unichronic/auvsim/README.md

# Adaptive Sonar Transmitter Payload — SIH26058

A low-power, real-time adaptive software-defined sonar transmitter for autonomous underwater
vehicles (AUVs) — built for Smart India Hackathon problem statement **SIH26058** (Ministry of
Earth Sciences / National Institute of Ocean Technology).

## The problem

AUV side-scan sonar performance is set by the physical characteristics of the transmitted
"ping." A high-frequency chirp (~500 kHz) gives sharp images but scatters instantly in muddy
or deep water; a low-frequency chirp (~100 kHz) penetrates murky water and travels far but
yields a blurry image. Sound also behaves differently with depth, turbidity, temperature and
salinity. For an AUV to map effectively without draining its battery, the transmitter needs to
behave like a software-defined radio — reshaping its analog pulse waveform in real time based
on what the water is actually doing.

## What's in this repository

- **[`sonar-transmitter/`](sonar-transmitter/)** — the physical hardware payload: pin-labelled
  pictorial wiring diagrams for all 9 build stages, full component specs and pin map, the
  golden-reference modulation/windowing simulator with its result set, and completed firmware.
  Start here for the hardware side.
- **Everything else at this repo's root** — the pre-silicon simulation bench: eight
  independent verification stages (integer-exact firmware reference, R-2R Monte Carlo, an
  independent SPICE cross-check, FPGA RTL simulation, an absorption/propagation model, and
  full scenario coverage against the problem statement), an interactive signal-lab GUI, and a
  hosted API. Laptop-verifies the whole transmitter chain before hardware measurement.
  Documented in full below.

## Architecture

```
Sensors → Adaptation logic (RP2040) → sample buffer (SRAM) → PIO + DMA
   → 74HC574 latch → 8-bit R-2R ladder DAC → 3rd-order active filter
   → analog amplitude control (digital pot, ahead of the output stage)
   → op-amp output → BNC → oscilloscope / spectrum analyser
```

Samples stream through the RP2040's PIO and DMA hardware at roughly **10 megasamples per
second with zero CPU cycles spent per sample** — the CPU is free to run the adaptation loop
and telemetry concurrently. The DAC is a hand-built 8-bit R-2R resistor ladder, not a DAC chip:
at 10 MS/s it reaches the real transmit band the problem statement describes, and it upgrades
cleanly on the same parallel-bus interface if a faster DAC is swapped in later. Amplitude is
controlled **in the analog domain** (a digital potentiometer ahead of the output op-amp), not
by scaling digital sample values — digital scaling costs DAC resolution exactly when the
signal is smallest. Four real sensors (temperature, turbidity, salinity, battery/power state)
plus one potentiometer standing in for depth (a bench cannot reproduce real hydrostatic
pressure, and the problem statement explicitly permits a dial for that one variable) drive an
adaptation loop that picks centre frequency, bandwidth, pulse duration, amplitude, and one of
three modulation types (LFM chirp, geometric sweep, Barker-13 phase code) every pulse.

Full component specs, pin map and rationale: [`sonar-transmitter/COMPONENTS.md`](sonar-transmitter/COMPONENTS.md).
Full stage-by-stage wiring diagrams: [`sonar-transmitter/diagrams/`](sonar-transmitter/diagrams/).

## Chosen algorithm and results

The modulation engine (LFM chirp, geometric sweep, Barker-13 phase code, all four required
windows) is verified by two independent simulation paths before any hardware measurement:
an integer-exact golden reference matched against a byte-for-byte RTL simulation of the actual
FPGA DDS, and a from-scratch Monte Carlo / SPICE cross-check of the analog chain. Highlights:

| Finding | Result |
|---|---|
| Quantisation SQNR, windowed LFM chirp (Hann / Blackman) | 45.7 / 44.9 dB |
| Reconstruction filter image rejection at the first DAC image (9.5 MHz) | 93.0 dB combined (analytic), 69.0 dB confirmed through the full time-domain chain |
| **Barker-13 phase code must use a rectangular window** | Confirmed independently in both simulators: tapering collapses the matched-filter sidelobe from ≈−22 dB to as little as −3.8 to −4.8 dB — windowing helps the chirps and destroys the phase code |
| **1% resistors are not good enough for the R-2R ladder** | 13.4% of Monte Carlo draws are non-monotonic, SFDR degrades to −49 dBc against a −48 dBc target. 0.1% gives 0% non-monotonic and 1.8 dB margin |
| Quarter-wave sine LUT sizing on the target FPGA | Exactly 100% of the SLG47910's block RAM (32,768 of 32,768 bits) — not "ample" as first assumed; quarter-wave symmetry is required, not optional |
| Digitally-scaled amplitude at 25%, SQNR cost | 37.7 dB (≈6 bits) — confirms analog amplitude control is the right call |
| Cross-check: nodal R-2R solve vs. an independent SPICE simulator | Agree to 6.9×10⁻¹⁴ LSB across all 256 codes |
| Cross-check: Verilog DDS vs. the Python golden reference | Byte-for-byte match over all 8,192 samples |

Full methodology and the complete numbers: [`sonar-transmitter/sim/README.md`](sonar-transmitter/sim/README.md)
(the hardware-facing simulator) and the [stage map](#stage-map) and
[cross-validation](#cross-validation) sections below (the full pre-silicon bench).

## Status

**Gates:** 7 of 8 pre-silicon verification gates pass (see [Status](#status) below) — the
remaining gate needs a synthesis run through the FPGA vendor's own GUI toolchain, which can't
be scripted.

**Hardware build:** the signal-chain architecture, component selection and modulation
algorithm are finalised and simulation-verified. Hardware bring-up follows a nine-stage,
test-gated build so a fault is caught at the smallest possible stage rather than debugged
blind in a fully assembled system:

- **Stage 1** — toolchain and first blink: passed
- **Stage 2** — DAC bus wiring proof (all 8 bus lines verified, correct identity, no bridges): passed
- Stages 3–9 (sensors, the R-2R ladder build, first waveform, filter/amplifier, full
  modulation set, closing the adaptation loop, power optimisation) — in progress

This covers the waveform engine, validated electrically per this round's requirements — no
transducer, water, or acoustic transmission is required or claimed this round. The acoustic
chain attaches at the BNC output, a deliberate module boundary, without requiring any change
upstream of it.

## What we looked at before deciding this

We researched a broad range of publicly documented approaches to this class of problem before
settling on this architecture. The patterns found, summarised without naming specific
projects: [`sonar-transmitter/research/DESIGN_RESEARCH.md`](sonar-transmitter/research/DESIGN_RESEARCH.md).

## License

MIT — see [`LICENSE`](LICENSE).

---

# Pre-silicon simulation bench

Laptop verification of the whole transmitter chain before any part is ordered.

**Not the deliverable.** SIH26058 requires a physical hardware unit — the build lives in
[`sonar-transmitter/`](sonar-transmitter/). This bench is preparation, and the
predicted-vs-measured overlay is evidence the system is understood, never a substitute for
building it.

## Run it

```bash
python3 run_all.py      # every runnable stage, then the gate check
```

or individually:

```bash
python3 run_sim0.py     # golden reference + C tables      (no extra tools)
python3 sim1_diff.py    # bit-exact firmware diff          (gcc)
python3 run_sim2.py     # R-2R Monte Carlo + filter        (no extra tools, ~90 s)
python3 run_sim4.py     # predicted spectrogram            (no extra tools)
python3 run_sim5.py     # absorption + adaptation table    (no extra tools)
python3 sim6_scenarios.py # PS scenarios → sensor inputs → adaptive sonar
python3 gate_check.py   # the 8 go/no-go gates
python3 sim2_spice_check.py  # ngspice vs the nodal solve, 256 codes
python3 sim3_check.py        # gateware diff vs SIM-0
```

The reusable ForgeFPGA baseline project is [`ForgeFpgaDDS.ffpga`](ForgeFpgaDDS.ffpga),
with the Shrike wrapper and pin map documented in
[`sim3_gateware/FORGEFPGA.md`](sim3_gateware/FORGEFPGA.md). It is the vendor-tool
input for the first Gate 6 synthesis pass; it does not replace the required
ForgeFPGA resource report or prove that the LUT array mapped to dedicated BRAM.

## Use the interactive signal lab

The original bench validates one fixed transmitter chain. The local GUI adds
the experiment loop: up to four configurable sensor channels with distinct
default behaviors (tone, up-chirp, burst, and dropout), recorded CSV/TXT trace
import, explicit water/environment controls, a selectable frequency algorithm,
all three PS waveform families (LFM, geometric, and phase-coded BPSK), an
explicit software-plugin handoff, and a separate hardware circuit model.
The patch bay keeps the simulated netlist visible:

```text
sensor inputs → algorithm → 32-bit DDS → 8-bit R-2R → reconstruction filter → output probe
```

The board is draggable; sensor blocks can be moved with a mouse or keyboard.
The hardware plane exposes clock, phase-accumulator, DAC, reference, filter,
and resistor-tolerance specs. The software plane lets you open the source file
you want to check, edit it in the browser, select a test scenario, and report
whether the adapter contract passed alongside the output frequency, voltage,
FTW, coherence, and waveforms.

The environment plane exposes temperature, salinity, depth, pH, source range,
ambient noise, and turbidity. For modeled channels, those values affect sound
speed, frequency-dependent Ainslie-McColl absorption, a clearly-labelled
turbidity scattering heuristic, propagation phase delay, and the noise floor
before estimation. Uploaded traces are not re-shaped: they are treated as
measurements that already include the conditions of their capture. These are
propagation-level preview controls, not calibrated transfer functions for the
project's final sensor hardware.

PS 26058 does not specify a number, model, or datasheet for the environmental
sensors. The four default inputs are therefore deliberately generic acoustic
fixtures. They exercise fusion, dropout, burst, chirp, and trace-import paths;
they are not claimed to be the project's physical sensors. To make the bench
project-accurate, map each selected sensor's model number/datasheet to its
response, sensitivity, bandwidth, and calibration file.

```bash
python3 launch_gui.py
# open http://127.0.0.1:8765
```

The GUI is dependency-free. `launch_gui.py` serves it locally; the same static
frontend and simulation are Vercel-ready through `vercel.json` and `api/`.
The sensor models are deterministic and reproducible; a recorded trace is
resampled at the configured simulation clock. The software editor is a safe
contract check: it does not execute arbitrary pasted code. A plugin must
contain the configured entrypoint (normally `on_measurement`) and call
`bench_set_algorithm(...)` or `bench_set_algorithm_from_config(...)`. The
selected algorithm then drives the hardware model. This is the integration
seam for the real product plugin; provide its SDK/API when it is ready to
replace the contract check with an actual compiler/runtime adapter.

## Run the PS scenarios

`sim6_scenarios.py` is the scenario-level experiment for SIH26058. It runs the
two conditions named by the PS—**Entering Muddy Estuary** and **Entering Clear
Shallow Reef**—plus the interpretable deployment classes: brackish transition,
deep clear, deep muddy, high-noise harbor, cold freshwater, warm hypersaline,
both hysteresis-boundary sides, and legal minimum/maximum input limits. Each
class runs through three coherent modeled acoustic input channels, the
existing fusion/DDS path, and an adaptive water-channel preview. The three
channels are a test harness for redundant input fusion, not a claim that the PS
requires three physical sensors.

The Shrike-Lite policy is intentionally small and deterministic: condition the
environment readings, select a fixed-point lookup profile with hysteresis on the
RP2040, and leave deterministic DDS/window/pulse synthesis to the FPGA. The
current profiles are LFM + Hann: 100–200 kHz for muddy water and 300–500 kHz
for clear shallow water. The coverage matrix also exercises all 12 environment
classes × 3 waveform families × 4 requested windows, sensor behaviors,
algorithm choices, hardware limits, invalid inputs, and frame-by-frame
clear→boundary→muddy→boundary→fault→dropout→recovery transitions. The exact integer DAC
path is used for LFM, geometric, and BPSK pulse checks. Phase-coded pulses use
a rectangular envelope even when another window is requested, because tapering
would change the Barker-chip correlation. The script writes
`out/sim6_scenario_report.json` plus `out/sim6_scenario_comparison.png`.
In the GUI, the scenario selector exposes the full catalog and the waveform
controls select the active modulation/window. Loading any catalog entry routes
the selected adaptive pulse through the modeled DDS → R-2R → filter → probe
chain. The **Run realtime coverage** action sends the complete environment
catalog through all waveform/window combinations in a bounded frame API, then
injects malformed configuration, sensor dropout, and recovery. Custom water
conditions can use either continuous DDS exploration or adaptive pulse output.

The sonar result is a relative link-budget preview, not a physical detection
claim. It currently omits target strength, beam pattern, multipath, transducer
efficiency, amplifier limits, and calibrated sediment particle data. Those must
be measured in a tank or open-water test before hardware settings are frozen.

## Deploy for team use

Vercel is the supported hosted path. Import this repository into Vercel or run
`vercel` from the repository root. The platform serves the `gui/` assets and
maps `/api/simulate` and `/api/status` to the Python Functions in `api/`.
The hosted API path uses no third-party runtime dependencies;
`launch_gui.py` remains the local path.

Hosted runs are independent per browser: the current layout is stored in
`localStorage`, not in a shared database. The hosted API uses the Python
standard library only and receives the submitted
sensor, hardware, connection, and plugin-contract payload for each run. Add
authentication and persistent storage before putting sensitive code or shared
project state behind a public URL. Netlify can serve the static GUI, but the
current Python API needs a separate service or a JavaScript/TypeScript port.

`POST /api/realtime` accepts a bounded `{base, frames, frame_period_ms}` payload.
Each frame may update the environment, waveform mode, and sensor state; malformed
frame data is reported as a recoverable fault; the
response reports selected profiles, hysteresis transitions, recoverable faults,
and host-side deadline measurements. It is a stateless deployment preview, not
a WebSocket or a substitute for measuring the RP2040 timer/DMA loop on the
target board.

It does not replace ForgeFPGA synthesis, the existing RTL/SPICE stages, or a
physical sensor/analog test. Those remain separate verification steps, while
the GUI gives you a repeatable whole-system test bench before those tools run.

## Design parameters

Everything lives in `params.py`. 8-bit R-2R ladder at 10 MS/s, 100–500 kHz
acoustic band, first image at 9.5 MHz, 3rd-order reconstruction filter at
700 kHz, Renesas SLG47910 (1120 LUTs, 32 kb BRAM, 50 MHz osc + PLL).

## Stage map

| stage | what it does | tools |
|---|---|---|
| `sim0_reference.py` | integer-exact golden reference (phase accumulator, LUT, Q15 window) | numpy/scipy |
| `sim1_firmware/` + `sim1_diff.py` | the real RP2040 routine compiled for x86, diffed byte-for-byte | gcc |
| `sim2_r2r.py` | R-2R Monte Carlo by exact nodal analysis | numpy |
| `sim2_filter.py` | reconstruction filter, slew and GBW headroom | scipy |
| `sim2_spice/` + `sim2_spice_check.py` | SPICE netlists — independent cross-check | ngspice ✅ |
| `sim3_gateware/` + `sim3_check.py` | DDS RTL with quarter-wave LUT | iverilog ✅ |
| `run_sim4.py` | chained prediction: codes → ladder → ZOH → filter → FFT | numpy/scipy |
| `sim5_propagation.py` | Ainslie-McColl + François-Garrison absorption | numpy |
| `sim6_scenarios.py` | PS scenarios → filtered inputs → Shrike-Lite pulse/link preview | numpy/scipy/matplotlib |

## Things this exercise actually found

1. **A 4096×8 sine LUT is exactly 100% of the SLG47910's BRAM** (32768 of
   32768 bits), not "ample". Quarter-wave symmetry (1025×8 = 25%) is required,
   not an optimisation.

2. **Quarter-wave symmetry needs an explicit +1 correction on the negative
   half.** The table is `round(127.5 + 127.5·sin)`, and `floor(-x) ≠ -floor(x)`,
   so naive negation is one LSB high across all 2047 negative-half entries —
   even-order distortion. Encoded in `dds.v`, verified over all 4096 addresses.

3. **Never window a phase-coded pulse.** Barker-13's −22.3 dB autocorrelation
   depends on equal-amplitude chips; tapering destroys it (−21.8 dB rect →
   −3.8 dB Blackman). Windowing helps the chirps and ruins the code.

4. **1% resistors are genuinely not good enough**: 13.4% of Monte Carlo draws
   are non-monotonic and SFDR degrades 10.7 dB worst case, landing at −49 dBc
   against a −48 dBc target. 0.1% gives 0% non-monotonic and 1.8 dB.

5. **Filter section order matters, and an op-amp macromodel can lie.** The
   first netlist draft put the passive RC pole *before* the Sallen-Key, which
   loads it: the corner fell to 449 kHz and 500 kHz droop was 3.6 dB instead
   of 0.5 dB. Moving the RC after the op-amp output fixed it. Separately, the
   placeholder op-amp had `Cp=39.8p`, giving GBW = 2e12 Hz — an ideal part
   that would have hidden every bandwidth problem the stage exists to find.
   Correct value for 20 MHz GBW with A0=1e5 and Rp=200 is `Cp=3.98u`.

6. **Down-chirps are where fixed-point bugs hide.** C's `/` truncates toward
   zero, Python's `//` floors; they agree only while the numerator is
   non-negative. An up-chirp passes either way, a down-chirp does not —
   `sim1_diff.py` carries a `lfm_down` case specifically to catch it.

## Toolchain

`iverilog` 13.0 and `ngspice` 47 are built from source into `~/.local`
(already on PATH via `.bashrc`). The disk was full, so they were **built in
`/dev/shm`** — a 7.7 GB tmpfs — and only the ~50 MB of final binaries landed
on disk. `gperf` was built first; iverilog's git tarball needs it to generate
its keyword lexer. No conda env and no user data deleted.

To rebuild: `gperf` → `iverilog` (run `sh autoconf.sh` first) → `ngspice`
(`./autogen.sh`, `--without-x --enable-xspice`), each `--prefix=$HOME/.local`.

## Cross-validation

Numbers confirmed by independent routes, which is the point of the structure:

- filter image rejection: −68.0 dB analytic vs 69.0 dB measured through the
  full SIM-4 time-domain chain
- 350 kHz SFDR: −60.2 dBc (SIM-0) vs −59.8 dBc (SIM-2 ideal ladder)
- absorption: Ainslie-McColl vs François-Garrison agree within 7% over 1–900 kHz
- ideal R-2R nodal solve reproduces V(255) = VREF·255/256 to 1e-14 LSB
- **ngspice agrees with the Python nodal solve to 6.9e-14 LSB across all 256
  codes** — the Monte Carlo behind the 0.1% resistor decision is confirmed by
  an independent circuit simulator
- **the Verilog DDS matches SIM-0 byte-for-byte over 8192 samples** in real
  RTL simulation, confirming the quarter-wave LUT and its +1 correction
- retuned filter netlist: −0.40 dB at 500 kHz and −69.3 dB at 9.5 MHz in
  ngspice, against −0.54 dB and −68.0 dB analytic

## Status

7 of 8 gates pass; all six stages run. Gate 6 remains partial for one reason
only: the BRAM question is answered and the RTL now passes real iverilog
simulation against SIM-0, but **LUT count needs a ForgeFPGA Workshop synthesis
run** — a proprietary GUI tool that cannot be scripted. Everything else,
including both independent cross-checks, is green.
