unichronic/auvsim/sonar-transmitter/diagrams/stage1_blink.png

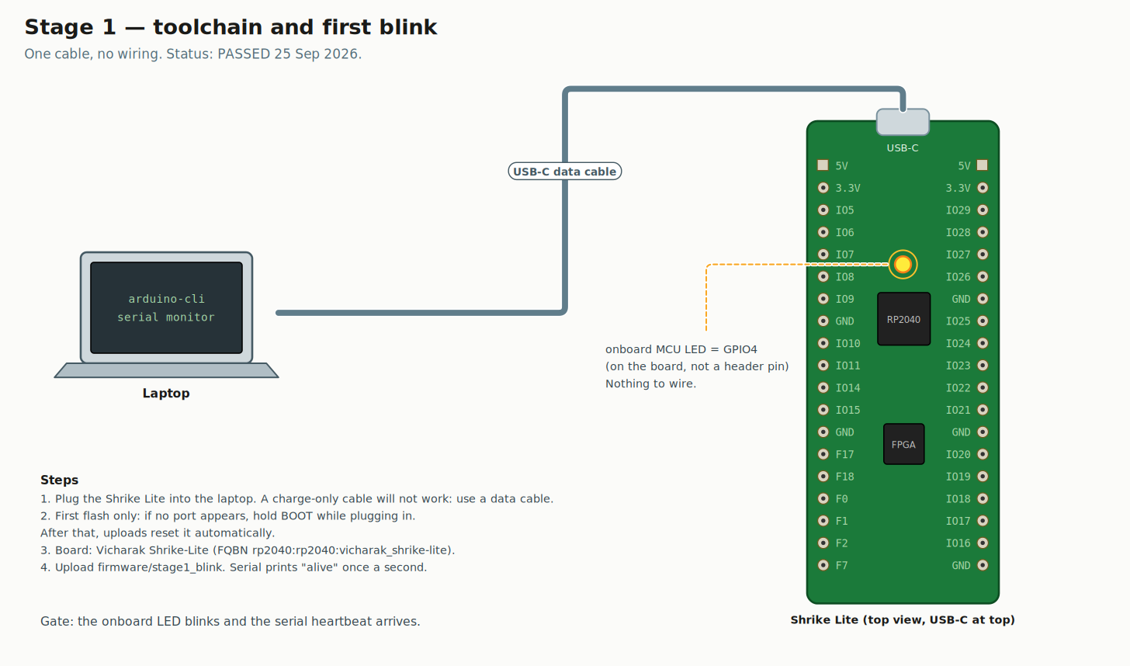
sonar-transmitter/diagrams/stage1_blink.png
