unichronic/auvsim/sonar-transmitter/diagrams/stage2_bus_loopback.png

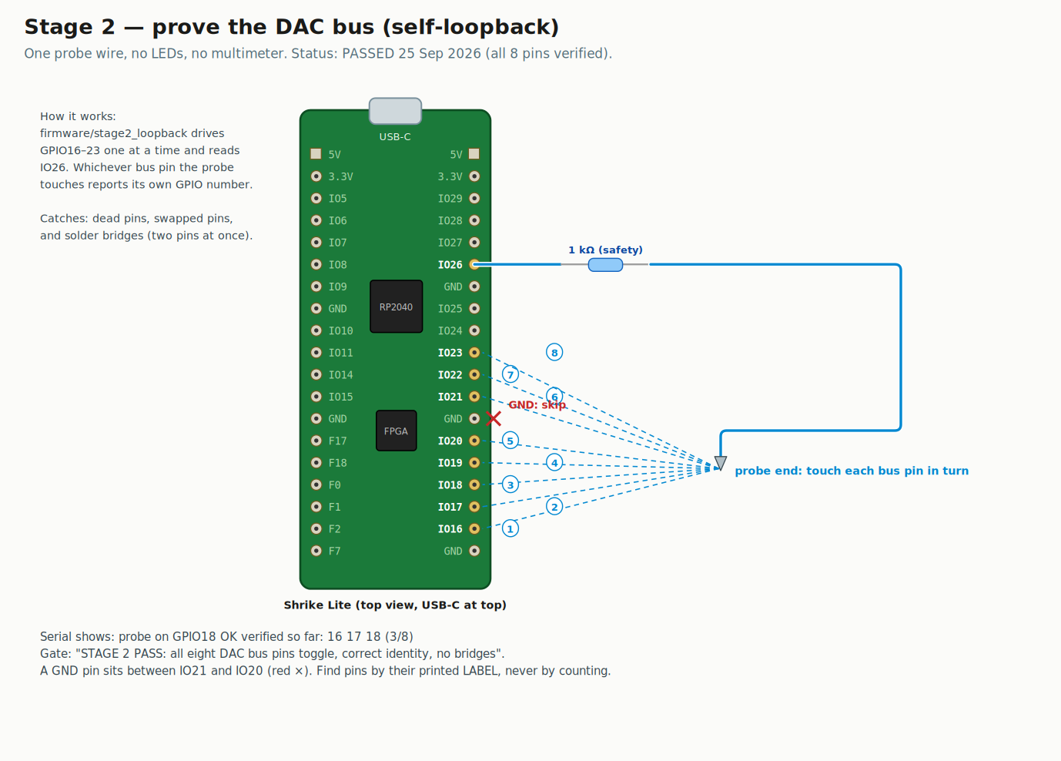
sonar-transmitter/diagrams/stage2_bus_loopback.png
