unichronic/auvsim/sonar-transmitter/diagrams/stage3_sensors.png

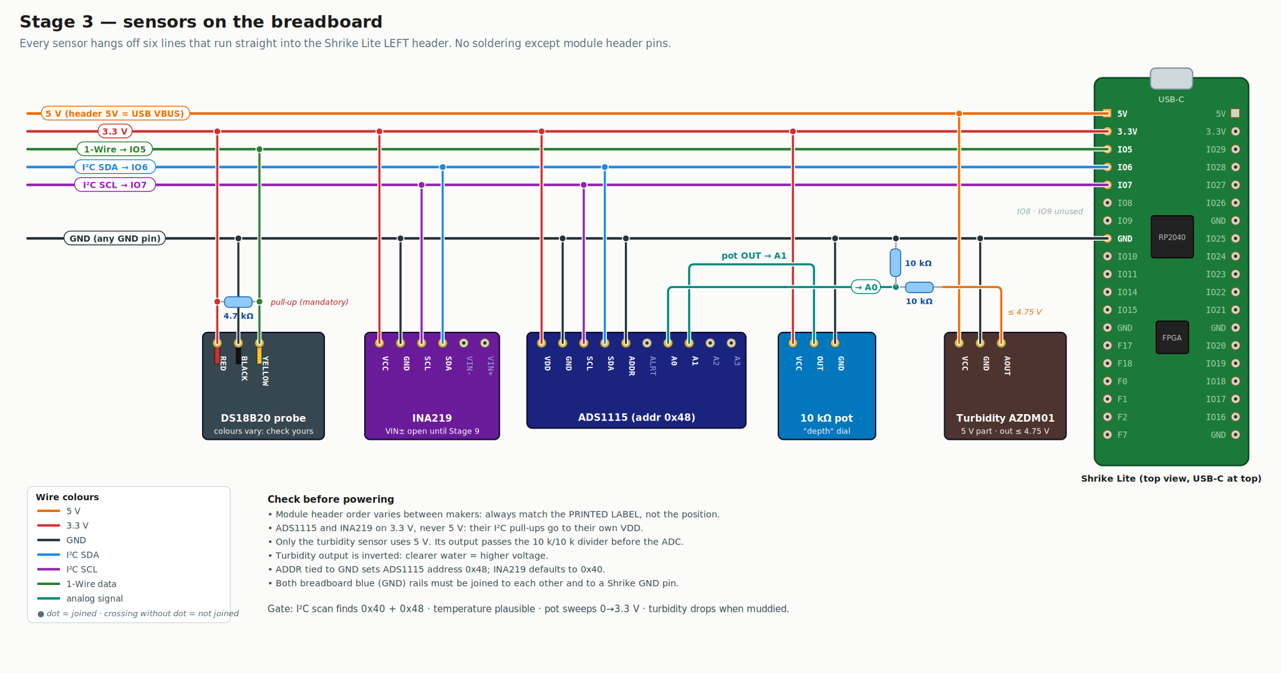
sonar-transmitter/diagrams/stage3_sensors.png
