unichronic/auvsim/sonar-transmitter/diagrams/stage4_latch_ladder.png

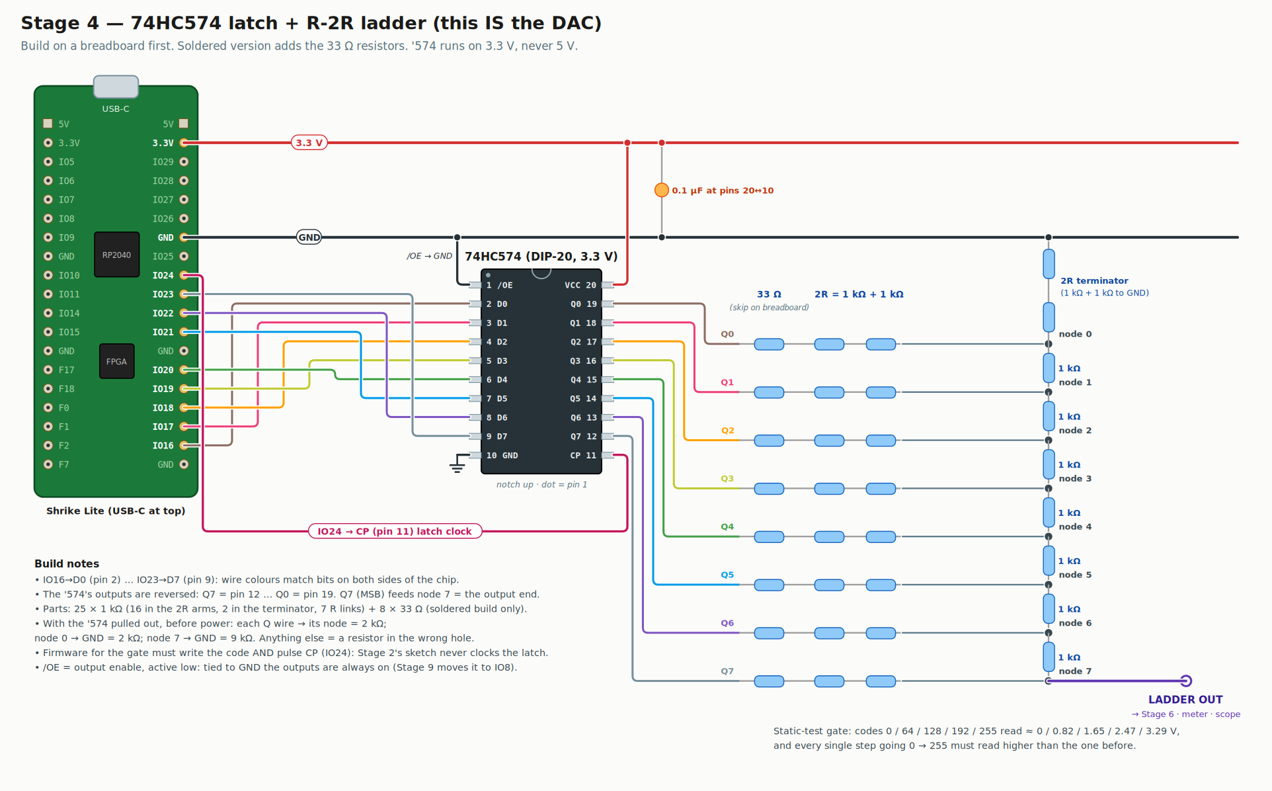
sonar-transmitter/diagrams/stage4_latch_ladder.png
