unichronic/auvsim/sonar-transmitter/diagrams/stage5_scope.png

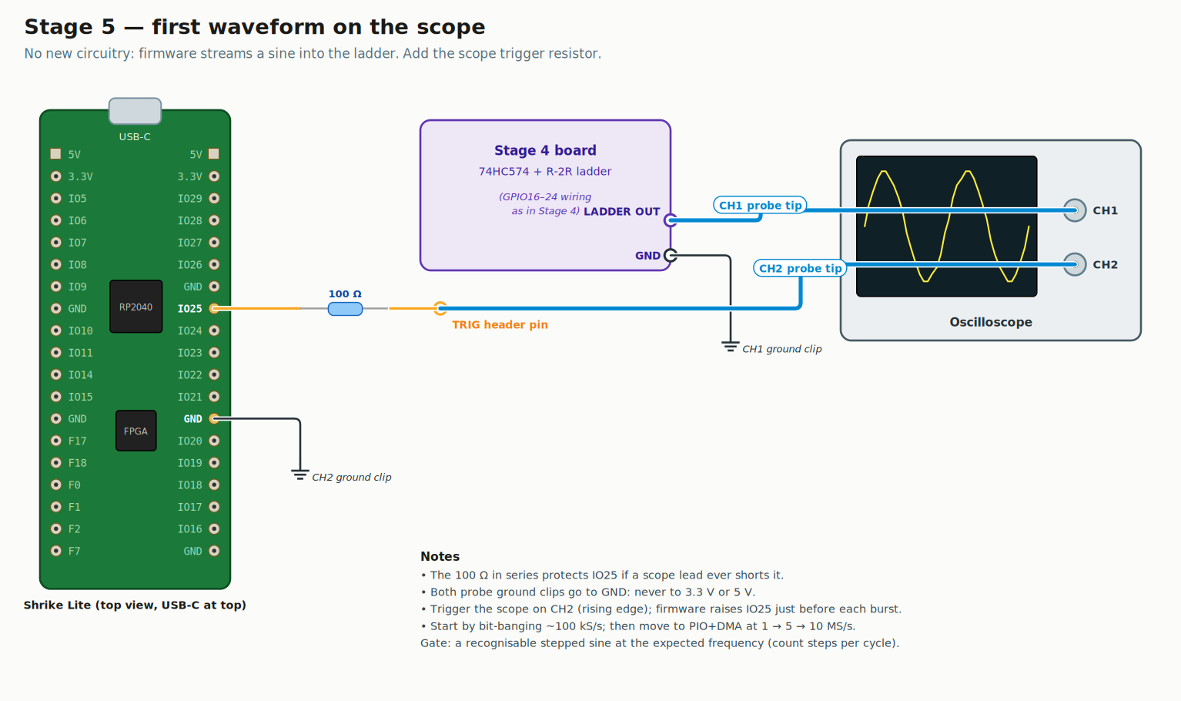
sonar-transmitter/diagrams/stage5_scope.png
