unichronic/auvsim/sonar-transmitter/diagrams/stage6_analog_chain.png

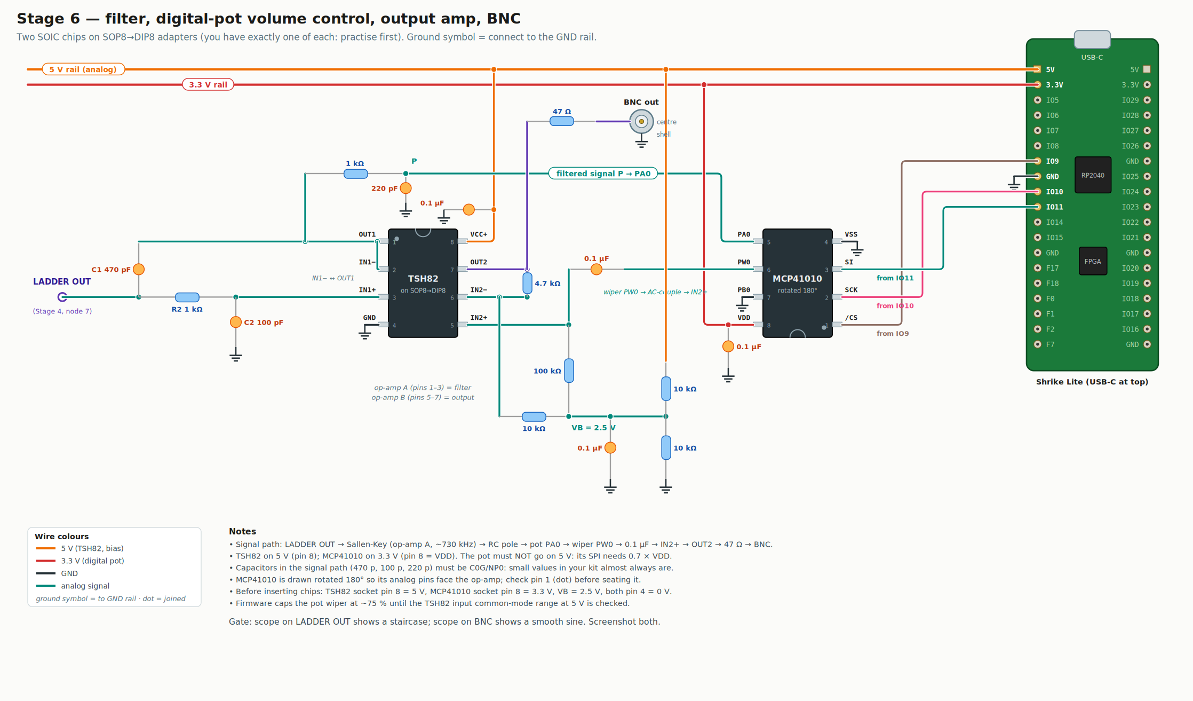
sonar-transmitter/diagrams/stage6_analog_chain.png
