unichronic/auvsim/sonar-transmitter/diagrams/stage7_system_overview.png

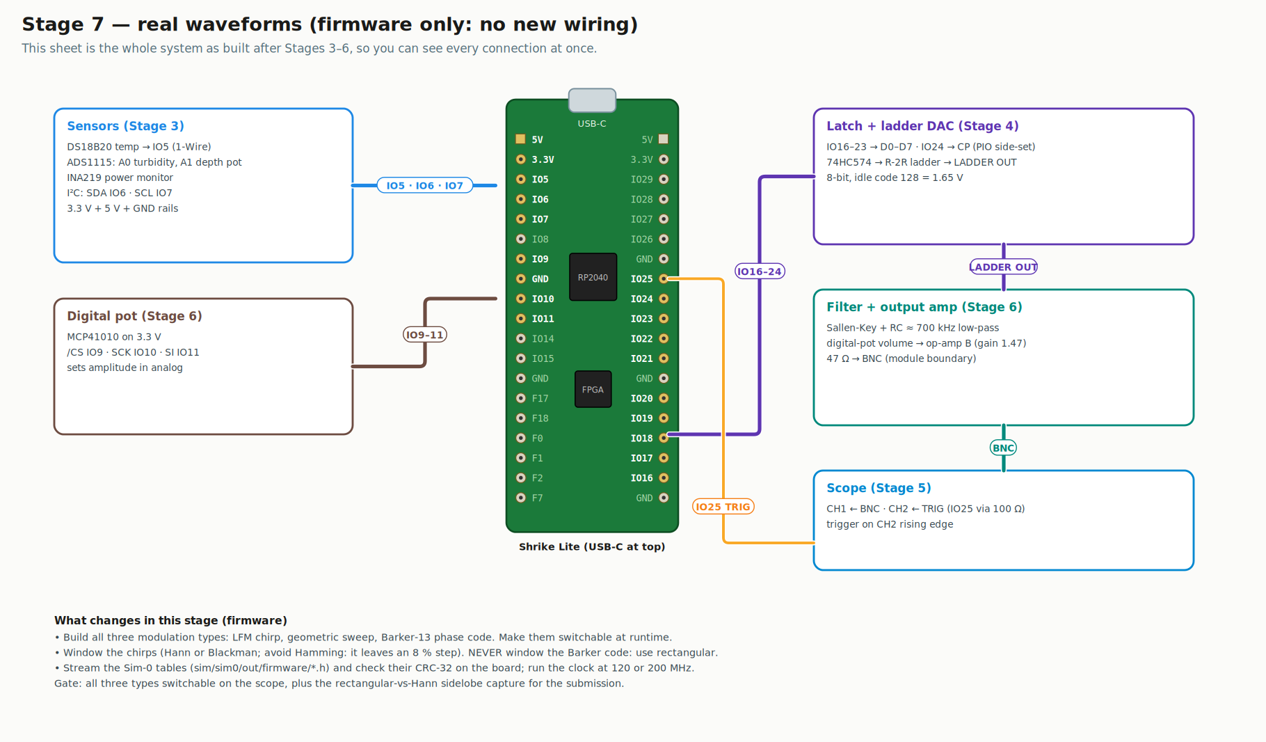
sonar-transmitter/diagrams/stage7_system_overview.png
