unichronic/auvsim/sonar-transmitter/diagrams/stage8_adaptation.png

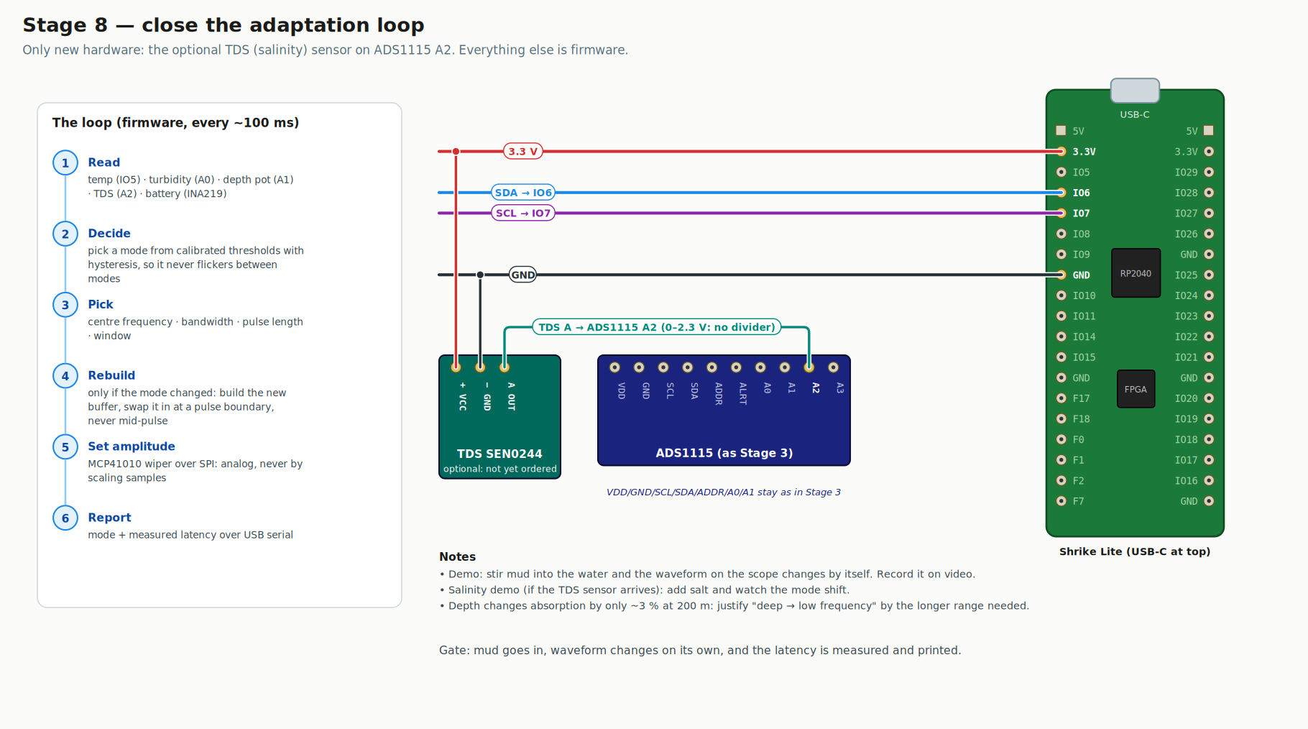
sonar-transmitter/diagrams/stage8_adaptation.png
