unichronic/auvsim/sonar-transmitter/diagrams/stage9_power.png

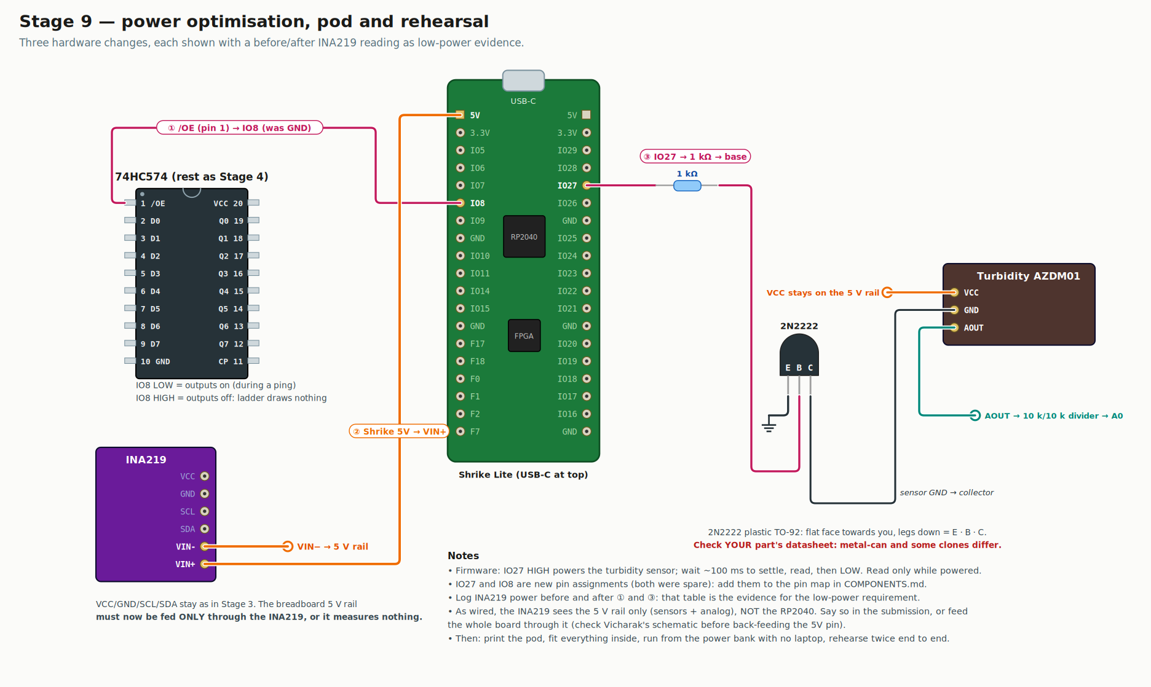
sonar-transmitter/diagrams/stage9_power.png
