unichronic/auvsim/(commit log)

2026-09-17 Clarify workflow and model sensor behavior
2026-09-17 Add environmental controls to sensor simulation
2026-09-17 Simulate PS adaptive sonar scenarios
2026-09-17 Expand adaptive sonar scenario coverage
2026-09-30 Add sonar-transmitter/: SIH26058 hardware payload (circuit diagrams, algorithm, results)
    The physical adaptive sonar transmitter payload for SIH26058 (Ministry
    of Earth Sciences / NIOT) -- a companion hardware project to this
    repo's existing AUV simulator, added alongside it without touching
    anything already here.
    Contents:
    - COMPONENTS.md -- full part specs, pin map, power budget
    - diagrams/ -- pictorial, pin-labelled wiring diagrams for all 9 build
    stages (source scripts + rendered SVG/PNG)
    - sim/ -- the golden-reference modulation/windowing/quantisation
    simulator (LFM chirp, geometric sweep, Barker-13 phase code), its
    full result set, and firmware-ready sample tables with CRC-32 ch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
2026-09-30 Restructure root README: lead with the project, demote the sim bench
    The root README previously opened directly with the pre-silicon
    simulation bench's usage docs, with no project-level framing. Added a
    new top section covering the actual project (problem statement,
    architecture, chosen algorithm and its cross-validated results,
    hardware build status, and a pointer to sonar-transmitter/ for the
    physical payload), and moved the existing bench documentation (run
    instructions, the interactive signal lab, PS scenario coverage,
    deployment, design parameters, stage map, findings, toolchain build
    notes, cross-validation, and gate status) down under its own "Pre-
    silicon simulation bench" heading. N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
